romkey/esp32-access-control/hw/reader/0.1.0/esp32-access-control-reader/back.png

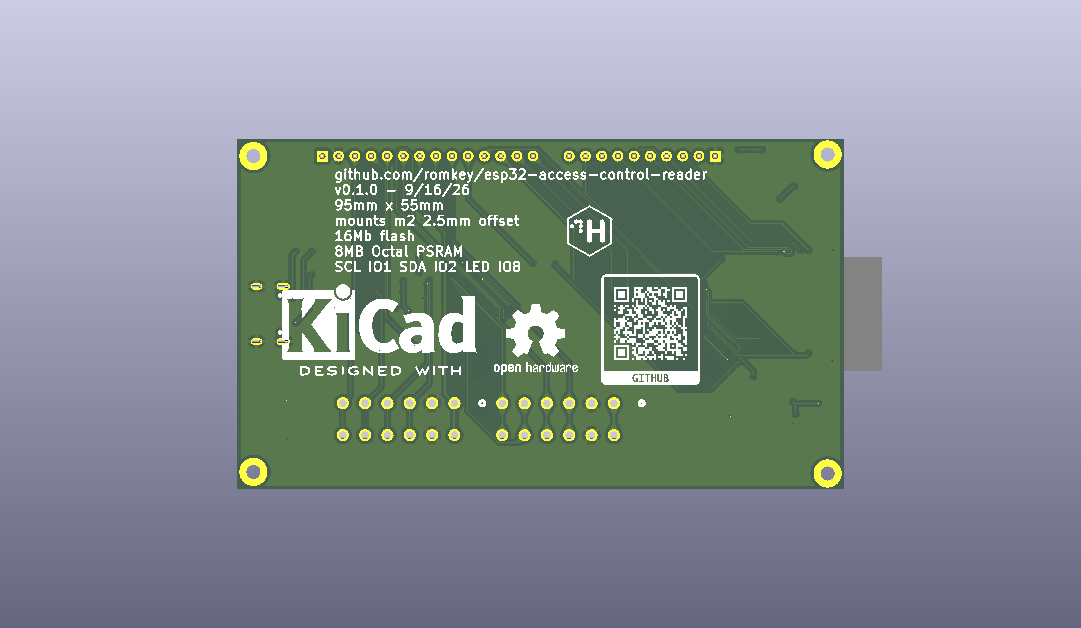
hw/reader/0.1.0/esp32-access-control-reader/back.png
