romkey/esp32-access-control/hw/reader/0.1.0/esp32-access-control-reader/front.png

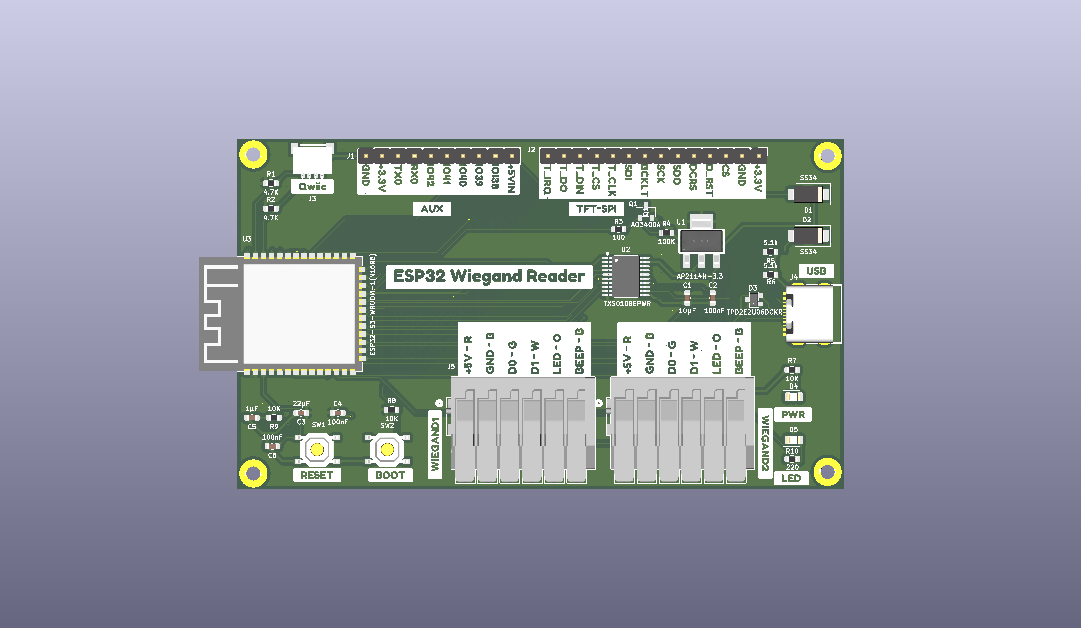
hw/reader/0.1.0/esp32-access-control-reader/front.png
