romkey/esp32-access-control/BOFFF.md

---
bofff_version: 1
board:
  name: ESP32 Access Control Base Board
  version: 0.1.0
  date: '2026-08-30'
  organization: PDX Hackerspace
  license: null
  repository: null
  repository_path: null
  notes:
  - John Romkey
source_files:
  ecad: KiCad
  project: esp32-access-control-reader.kicad_pro
  schematic: esp32-access-control-reader.kicad_sch
  pcb: esp32-access-control-reader.kicad_pcb
  step: null
  dxf: null
  bom: null
form:
  units: mm
  origin: top-left of bounding box, x right, y down
  outline:
    shape: rectangle
    width: 95
    height: 55
  thickness: 1.6
  copper_layers: 2
  max_height_top: null
  max_height_bottom: null
mounting:
  center:
    x: 47.5
    y: 27.5
  center_is: bounding box centre, not the outline centroid
  holes:
  - ref: MNT1
    x: 2.5
    y: 2.5
    offset_x: -45
    offset_y: -25
    diameter: 2.2
  - ref: MNT2
    x: 92.5
    y: 2.75
    offset_x: 45
    offset_y: -24.75
    diameter: 2.2
  - ref: MNT3
    x: 92.5
    y: 52.25
    offset_x: 45
    offset_y: 24.75
    diameter: 2.2
  - ref: MNT4
    x: 2.5
    y: 52.5
    offset_x: -45
    offset_y: 25
    diameter: 2.2
power:
  rails:
  - net: GND
    kind: ground
    connections: 24
  - net: +3V3
    kind: supply
    connections: 12
  - net: +5V
    kind: supply
    connections: 4
  - net: +5V_IN
    kind: supply
    connections: 2
  - net: VBUS
    kind: supply
    connections: 2
  - net: +3.3V
    kind: supply
    connections: 1
  usb:
    present: true
    type: null
    ref: J4
  battery:
    present: false
  input_voltage: null
  current_typical: null
  current_peak: null
connectors:
- ref: J1
  part: Conn_01x10_MountingPin
  footprint: Connector_PinHeader_2.54mm:PinHeader_1x10_P2.54mm_Vertical
  x: 20.13
  y: 2.75
  populated: true
  pins:
  - pad: '1'
    net: GND
  - pad: '2'
    net: /+3.3V
  - pad: '3'
    net: /TX0
  - pad: '4'
    net: /RX0
  - pad: '5'
    net: /IO42
  - pad: '6'
    net: /IO41
  - pad: '7'
    net: /IO40
  - pad: '8'
    net: /IO39
  - pad: '9'
    net: /IO38
  - pad: '10'
    net: /+5V_IN
- ref: J2
  part: '~'
  footprint: Connector_PinHeader_2.54mm:PinHeader_1x14_P2.54mm_Vertical
  x: 81.69
  y: 2.75
  populated: true
  pins:
  - pad: '1'
    net: +3V3
  - pad: '2'
    net: GND
  - pad: '3'
    net: /CS
  - pad: '4'
    net: /DSP_RST
  - pad: '5'
    net: /DCRS
  - pad: '6'
    net: /SDO
  - pad: '7'
    net: /SCK
  - pad: '8'
    net: Net-(J2-LED)
  - pad: '9'
    net: /SDI
  - pad: '10'
    net: /T_CLK
  - pad: '11'
    net: /T_CS
  - pad: '12'
    net: /T_DIN
  - pad: '13'
    net: /T_DO
  - pad: '14'
    net: /T_IRQ
- ref: J3
  part: SM04B-SRSS-TB_(LF)(SN)
  footprint: easyeda2kicad:CONN-SMD_4P-P1.00_SM04B-SRSS-TB-LF-SN
  x: 11.75
  y: 3.5
  populated: true
  pins:
  - pad: '1'
    net: GND
  - pad: '2'
    net: +3V3
  - pad: '3'
    net: /SDA
  - pad: '4'
    net: /SCL
- ref: J4
  part: TYPE-C-31-M-12
  footprint: easyeda2kicad:USB-C-SMD_MC-311D
  x: 89.625
  y: 27.5
  populated: true
  pins:
  - pad: '1'
    net: GND
  - pad: '2'
    net: GND
  - pad: '3'
    net: GND
  - pad: '4'
    net: GND
  - pad: A1-B12
    net: GND
  - pad: A4-B9
    net: VBUS
  - pad: A5
    net: Net-(J4-CC1)
  - pad: A6
    net: /D+
  - pad: A7
    net: /D-
  - pad: B1-A12
    net: GND
  - pad: B4-A9
    net: VBUS
  - pad: B5
    net: Net-(J4-CC2)
  - pad: B6
    net: /D+
  - pad: B7
    net: /D-
- ref: J5
  part: 2601-1106
  footprint: easyeda2kicad:CONN6_2601-1106_WAG
  x: 36
  y: 41.5
  populated: true
  pins:
  - pad: '1'
    net: +5V
  - pad: '2'
    net: +5V
  - pad: '3'
    net: GND
  - pad: '4'
    net: GND
  - pad: '5'
    net: /W1-1
  - pad: '6'
    net: /W1-1
  - pad: '7'
    net: /W1-2
  - pad: '8'
    net: /W1-2
  - pad: '9'
    net: /W1-3
  - pad: '10'
    net: /W1-3
  - pad: '11'
    net: /W1-4
  - pad: '12'
    net: /W1-4
- ref: J6
  part: 2601-1106
  footprint: easyeda2kicad:CONN6_2601-1106_WAG
  x: 61
  y: 41.5
  populated: true
  pins:
  - pad: '1'
    net: +5V
  - pad: '2'
    net: +5V
  - pad: '3'
    net: GND
  - pad: '4'
    net: GND
  - pad: '5'
    net: /W2-1
  - pad: '6'
    net: /W2-1
  - pad: '7'
    net: /W2-2
  - pad: '8'
    net: /W2-2
  - pad: '9'
    net: /W2-3
  - pad: '10'
    net: /W2-3
  - pad: '11'
    net: /W2-4
  - pad: '12'
    net: /W2-4
interfaces:
  i2c:
  - name: primary
    nets:
    - /SCL
    - /SDA
    pullups:
    - ref: R1
      line: SCL
      net: /SCL
      pulls_to: +3V3
      voltage: 3.3
      value: 4.7K
      resistance: 4700
    - ref: R2
      line: SDA
      net: /SDA
      pulls_to: +3V3
      voltage: 3.3
      value: 4.7K
      resistance: 4700
    devices:
    - ref: U3
      part: ESP32-S3-WROOM-1(N16R8)
      address: null
    exposed_on:
    - J3
---

# ESP32 Access Control Base Board — BOFFF

**BOFFF** — a Bill Of Form, Fit and Function. A summary of this
board's physical and electrical facts for anyone designing an
enclosure, a mount, or a mating board.

- **Form** — outline, thickness, layer count.
- **Fit** — mounting holes and connector positions.
- **Function** — power rails and the buses the board exposes.

## Coordinates

Millimetres. The origin is the **top-left corner of the board
outline's bounding box**, with X increasing right and Y increasing
**down**. This is the opposite of the usual mathematical
convention and is the most likely source of a silent error in
anything consuming this file.

Mounting holes additionally carry `offset_x`/`offset_y`, measured
from `mounting.center`, so a symmetric pattern reads as the
matched pair it is. Y still increases **down**, so a hole above
the centre has a negative `offset_y`.

Both anchors are derived from the **bounding box**, so both are
well defined for any outline — but on a board that is not a
rectangle, neither need be a point on the board. The top-left of
a round board's bounding box sits in free space, and the centre
of an irregular one is the box's centre, not the outline's
centroid. Check `form.outline.shape` before measuring to either.

## Generated, not authored

Everything above was extracted from the KiCad files listed under
`source_files`. Regenerate it rather than editing it by hand:

```bash
kilint bofff . > BOFFF.md
```

For exact geometry — curves, slots, internal cutouts, component
heights — use the STEP/DXF exports rather than this summary. A
bounding box is not an outline.

## Complete by hand

These are not recorded in the KiCad files and are emitted as
`null`. They need a human:

- `form.max_height_top` — tallest component above the board; from the 3D models, not the PCB
- `form.max_height_bottom` — tallest component below the board; same
- `power.input_voltage` — the operating range; the netlist does not say
- `power.current_typical` — a measurement
- `power.current_peak` — a measurement
- `source_files.step` — path to the 3D export, once you make one
- `source_files.dxf` — path to the 2D outline export, once you make one
- `source_files.bom` — path to the exported BOM
- `board.repository_path` — the project is not inside a git repository
- `board.license` — no license found in the title block or silkscreen
