romkey/esp32-access-control/hw/reader/0.1.0/esp32-access-control-reader/esp32-access-control-reader.pdf

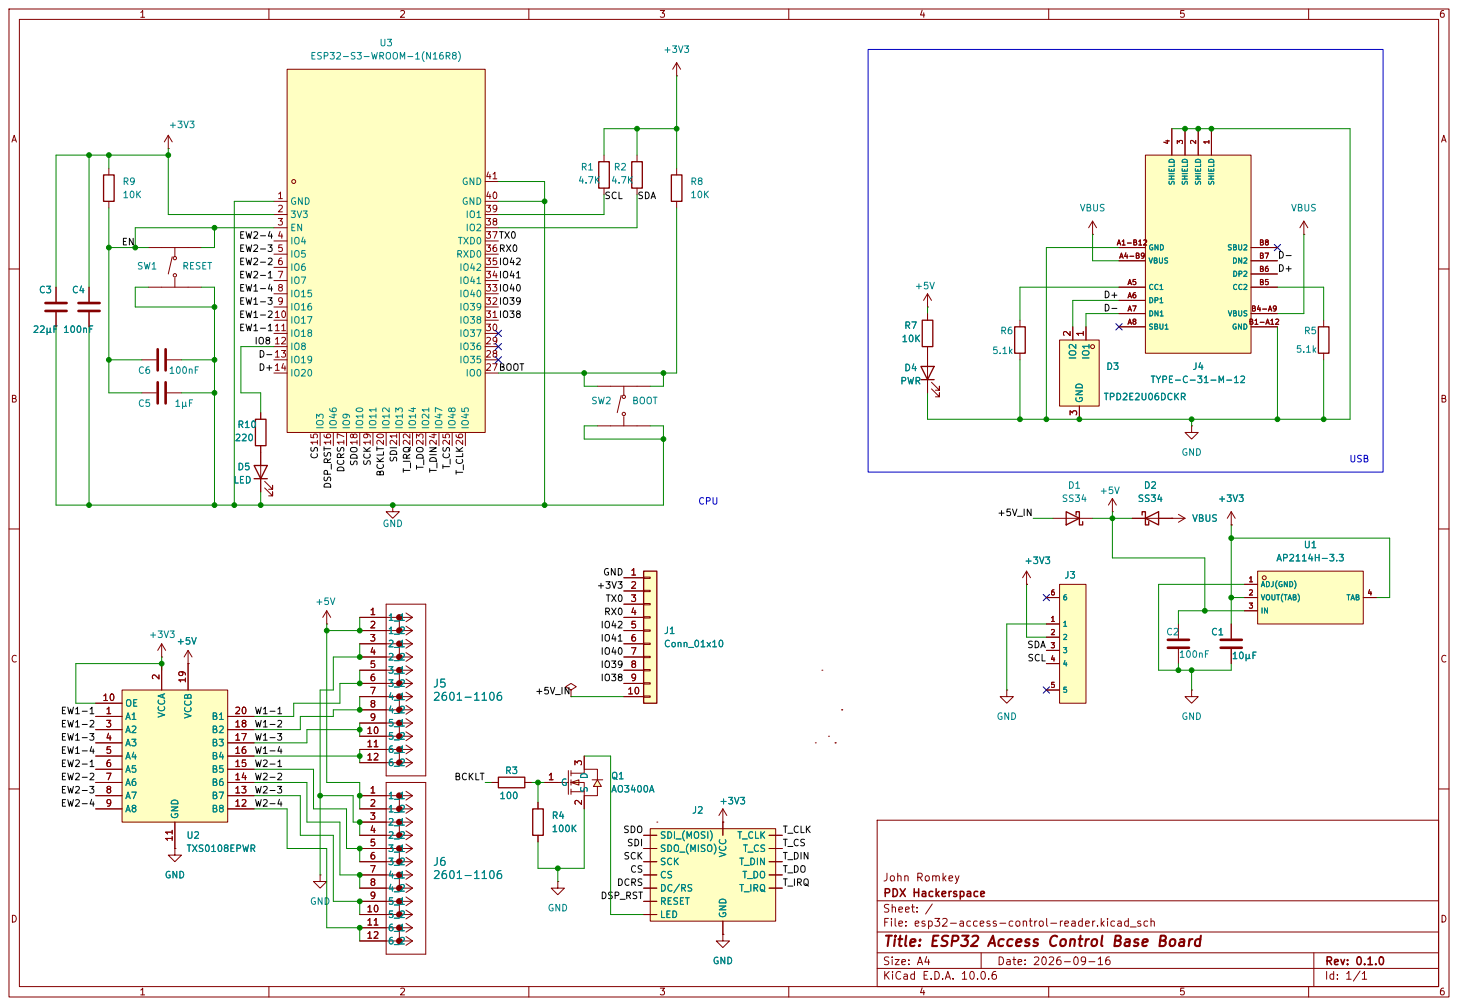
[picture p4: page 1]

3_2 6
4_1 7
4_2 8
5_1 9

PDX Hackerspace
Sheet: /
File: esp32-access-control-reader.kicad_sch
Title: ESP32 Access Control Base Board

Size: A4 | Rev: 0.1.0
KiCad E.D.A. 10.0.6 | Id: 1/1
