romkey/esp32-access-control/hw/reader/0.1.0/esp32-access-control-reader/esp32-access-control-reader.kicad_pcb

## KiCad design hw/reader/0.1.0/esp32-access-control-reader/esp32-access-control-reader.kicad_pcb (2026-09-30)

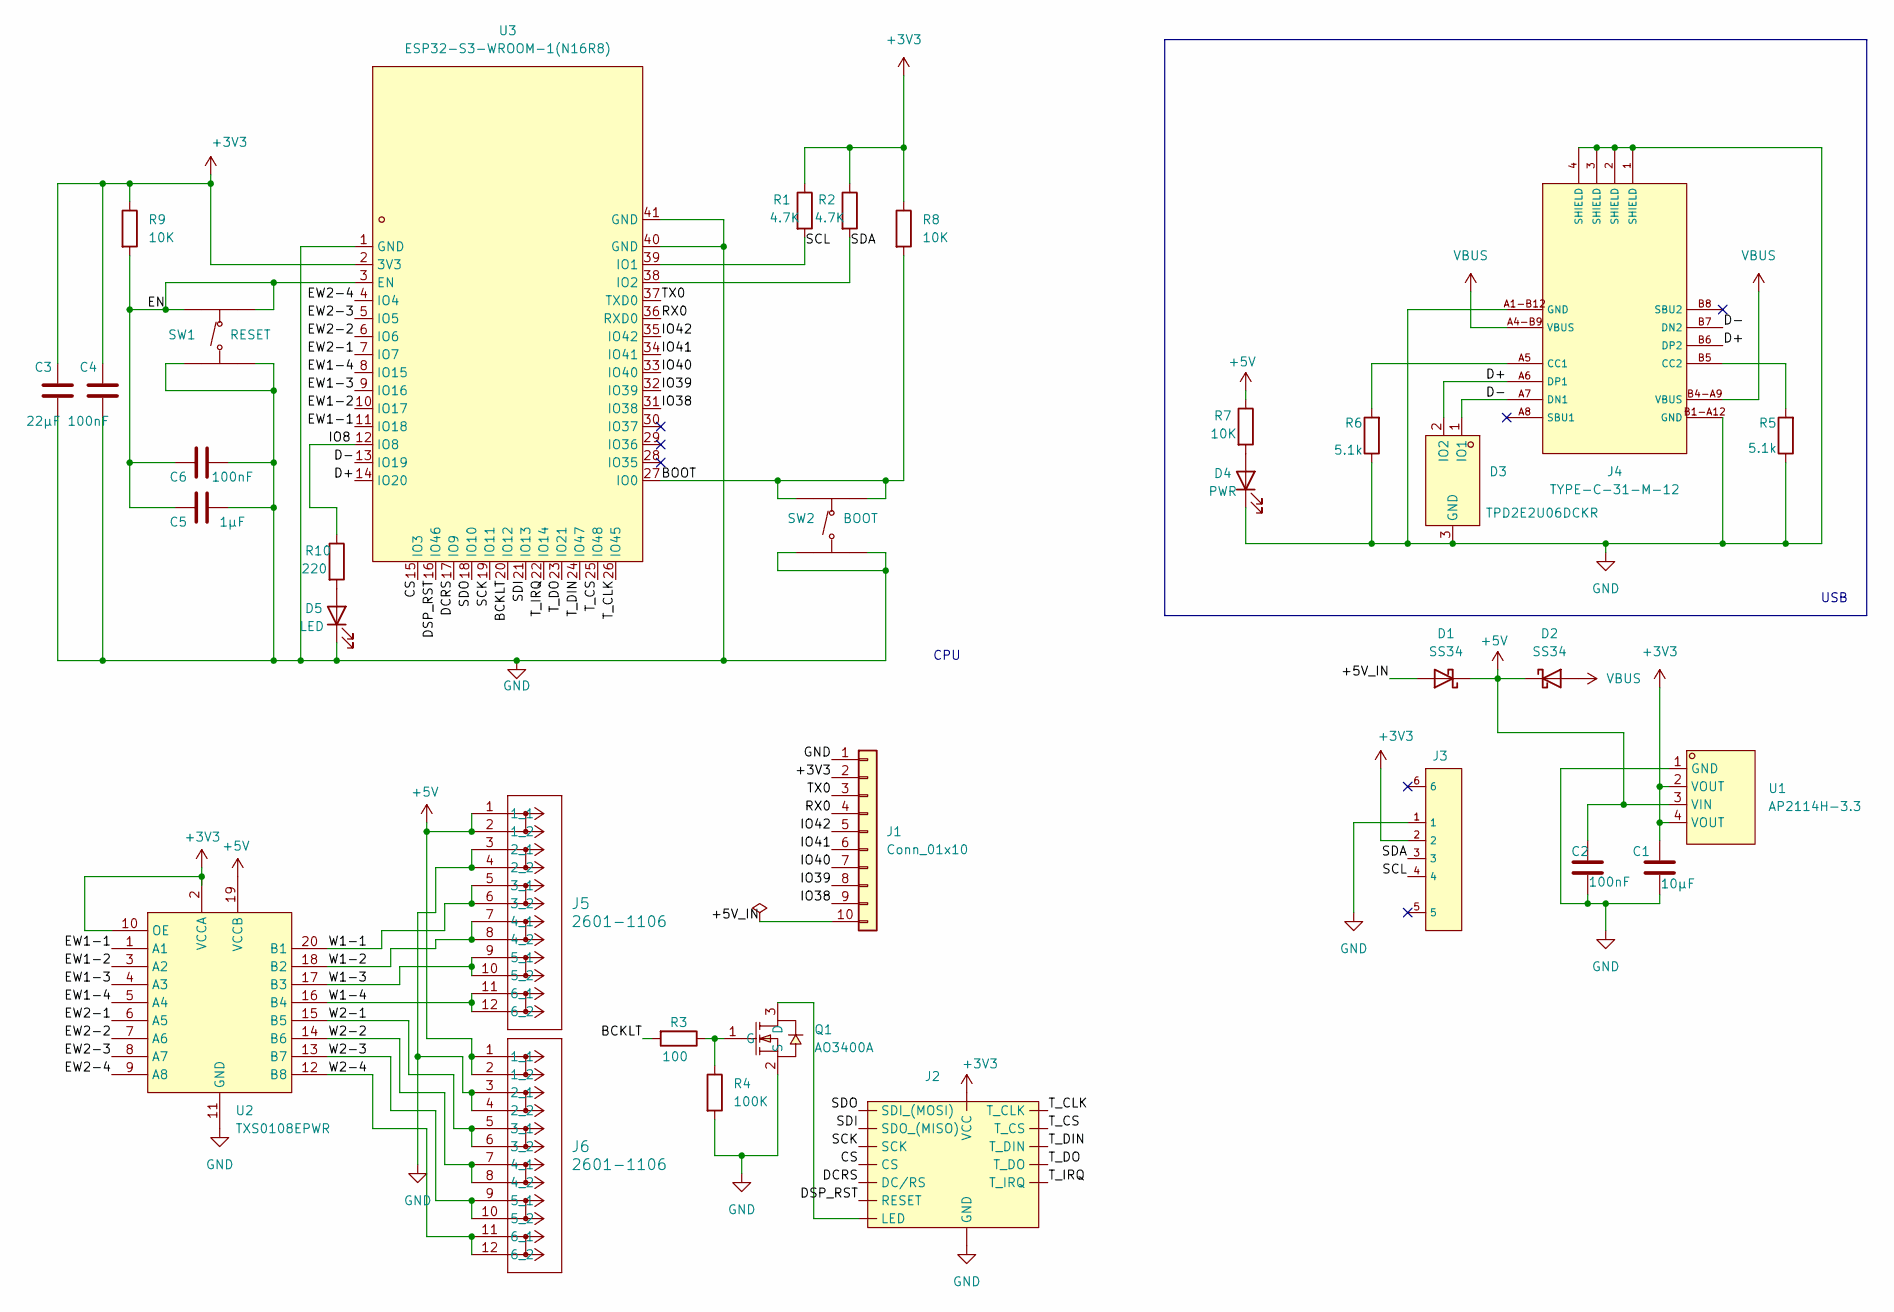
[picture p5: schematic esp32-access-control-reader.kicad_sch, ESP32 Access Control Base Board]

Parts:
C1: 10µF; C_0603_1608Metric; LCSC C19702
C2, C4, C6: 100nF; C_0603_1608Metric; LCSC C14663
C3: 22µF; C_0603_1608Metric; LCSC C59461
C5: 1µF; C_0603_1608Metric; LCSC C15849
D1, D2: SS34; D_SMA; LCSC Part C8678
D3: TPD2E2U06DCKR; SC-70-3_L2.0-W1.3-P0.65-LS2.1-BL; LCSC Part C1855726
D4: PWR; LED_0805_2012Metric; LCSC C84256
D5: LED; LED_0805_2012Metric; LCSC C2297
J1: Conn_01x10; PinHeader_1x10_P2.54mm_Vertical
J2: PinHeader_1x14_P2.54mm_Vertical
J3: SM04B-SRSS-TB_(LF)(SN); CONN-SMD_4P-P1.00_SM04B-SRSS-TB-LF-SN; LCSC C160404
J4: TYPE-C-31-M-12; USB-C-SMD_MC-311D; LCSC C136423
J5, J6: 2601-1106; CONN6_2601-1106_WAG
Q1: AO3400A; SOT-23-3_L2.9-W1.3-P1.90-LS2.4-BR; LCSC Part C20917
R1, R2: 4.7K; R_0603_1608Metric; LCSC C23162
R3: 100; R_0603_1608Metric; LCSC Part C22775
R4: 100K; R_0603_1608Metric; LCSC Part C25803
R5, R6: 5.1k; R_0603_1608Metric; LCSC C23186
R7, R8, R9: 10K; R_0603_1608Metric; LCSC C25804
R10: 220; R_0603_1608Metric; LCSC C22962
SW1: RESET; SW-SMD_4P-L5.1-W5.1-P3.70-LS6.5-TL_H1.5; LCSC C318884
SW2: BOOT; SW-SMD_4P-L5.1-W5.1-P3.70-LS6.5-TL_H1.5; LCSC C318884
U1: AP2114H-3.3; SOT-223_L6.7-W3.5-P2.30-BR; LCSC C150716
U2: TXS0108EPWR; TSSOP-20_L6.5-W4.4-P0.65-LS6.4-BL; LCSC Part C17206
U3: ESP32-S3-WROOM-1(N16R8); WIRELM-SMD_ESP32-S3-WROOM-1; LCSC Part C2913202

Connections:
+3V3: C1.1, C3.1, C4.1, J1.2, J2.1 (VCC), J3.2, R1.1, R2.1, R8.1, R9.1, U1.2 (VOUT), U1.4 (VOUT), U2.2 (VCCA), U2.10 (OE), U3.2 (3V3)
+5V: C2.1, D1.1 (K), D2.1 (K), J5.1 (1_1), J5.2 (1_2), J6.1 (1_1), J6.2 (1_2), R7.1, U1.3 (VIN), U2.19 (VCCB)
/+5V_IN: D1.2 (A), J1.10
/BCKLT: R3.2, U3.20 (IO12)
/BOOT: R8.2, SW2.1 (A), SW2.2 (B), U3.27 (IO0)
/CS: J2.3 (CS), U3.15 (IO3)
/D+: D3.2 (IO2), J4.A6 (DP1), J4.B6 (DP2), U3.14 (IO20)
/D-: D3.1 (IO1), J4.A7 (DN1), J4.B7 (DN2), U3.13 (IO19)
/DCRS: J2.5 (DC/RS), U3.17 (IO9)
/DSP_RST: J2.4 (RESET), U3.16 (IO46)
/EN: C5.1, C6.1, R9.2, SW1.1 (A), SW1.2 (B), U3.3 (EN)
/EW1-1: U2.1 (A1), U3.11 (IO18)
/EW1-2: U2.3 (A2), U3.10 (IO17)
/EW1-3: U2.4 (A3), U3.9 (IO16)
/EW1-4: U2.5 (A4), U3.8 (IO15)
/EW2-1: U2.6 (A5), U3.7 (IO7)
/EW2-2: U2.7 (A6), U3.6 (IO6)
/EW2-3: U2.8 (A7), U3.5 (IO5)
/EW2-4: U2.9 (A8), U3.4 (IO4)
/IO8: R10.1, U3.12 (IO8)
/IO38: J1.9, U3.31 (IO38)
/IO39: J1.8, U3.32 (IO39)
/IO40: J1.7, U3.33 (IO40)
/IO41: J1.6, U3.34 (IO41)
/IO42: J1.5, U3.35 (IO42)
/RX0: J1.4, U3.36 (RXD0)
/SCK: J2.7 (SCK), U3.19 (IO11)
/SCL: J3.4, R1.2, U3.39 (IO1)
/SDA: J3.3, R2.2, U3.38 (IO2)
/SDI: J2.9 (SDO_(MISO)), U3.21 (IO13)
/SDO: J2.6 (SDI_(MOSI)), U3.18 (IO10)
/TX0: J1.3, U3.37 (TXD0)
/T_CLK: J2.10 (T_CLK), U3.26 (IO45)
/T_CS: J2.11 (T_CS), U3.25 (IO48)
/T_DIN: J2.12 (T_DIN), U3.24 (IO47)
/T_DO: J2.13 (T_DO), U3.23 (IO21)
/T_IRQ: J2.14 (T_IRQ), U3.22 (IO14)
/W1-1: J5.5 (3_1), J5.6 (3_2), U2.20 (B1)
/W1-2: J5.7 (4_1), J5.8 (4_2), U2.18 (B2)
/W1-3: J5.9 (5_1), J5.10 (5_2), U2.17 (B3)
/W1-4: J5.11 (6_1), J5.12 (6_2), U2.16 (B4)
/W2-1: J6.5 (3_1), J6.6 (3_2), U2.15 (B5)
/W2-2: J6.7 (4_1), J6.8 (4_2), U2.14 (B6)
/W2-3: J6.9 (5_1), J6.10 (5_2), U2.13 (B7)
/W2-4: J6.11 (6_1), J6.12 (6_2), U2.12 (B8)
GND: C1.2, C2.2, C3.2, C4.2, C5.2, C6.2, D3.3 (GND), D4.1 (K), D5.1 (K), J1.1, J2.2 (GND), J3.1, J4.1 (SHIELD), J4.2 (SHIELD), J4.3 (SHIELD), J4.4 (SHIELD), J4.A1-B12 (GND), J4.B1-A12 (GND), J5.3 (2_1), J5.4 (2_2), J6.3 (2_1), J6.4 (2_2), Q1.2 (S), R4.2, R5.1, R6.1, SW1.3 (C), SW1.4 (D), SW2.3 (C), SW2.4 (D), U1.1 (GND), U2.11 (GND), U3.1 (GND), U3.40 (GND), U3.41 (GND)
unnamed: D4.2 (A), R7.2
unnamed: D5.2 (A), R10.2
unnamed: J2.8 (LED), Q1.3 (D)
unnamed: J4.A5 (CC1), R6.2
unnamed: J4.B5 (CC2), R5.2
unnamed: Q1.1 (G), R3.1, R4.1
VBUS: D2.2 (A), J4.A4-B9 (VBUS), J4.B4-A9 (VBUS)

Notes on the sheet:
CPU
USB

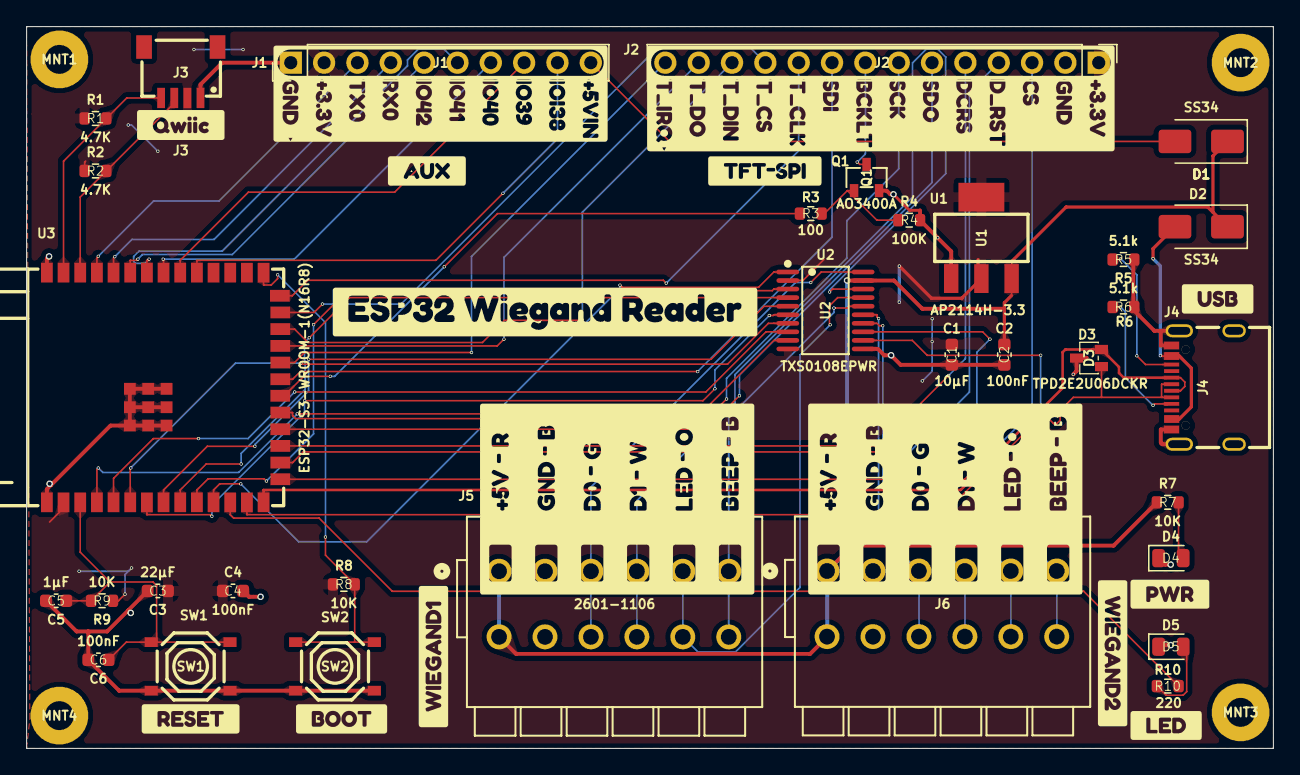
[picture p6: board esp32-access-control-reader.kicad_pcb from above]

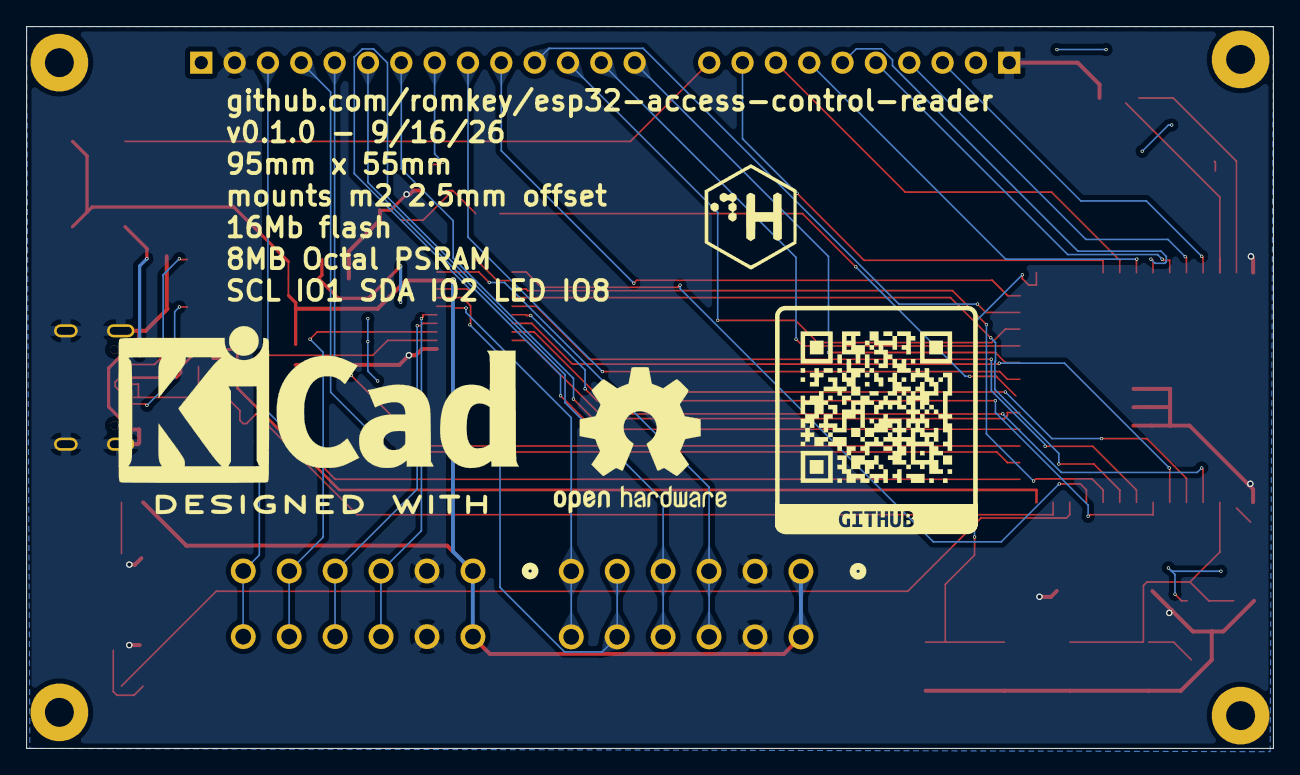
[picture p7: board esp32-access-control-reader.kicad_pcb from below]

Board: 2 copper layers, 95.0 x 55.0 mm, 54 parts (2 on the bottom side), 53 nets.

Other parts of the board:
MNT1, MNT2, MNT3, MNT4: MountingHole_2.2mm_M2_Pad
NOT2: CTRLH Logo
kobee-studio-1: G***; kobee-studio-6AA82569
kobee-studio-2: G***; kobee-studio-6AA4CD99
kobee-studio-3: G***; kobee-studio-6A958584
kobee-studio-4: G***; kobee-studio-6AA4CF77
kobee-studio-5: G***; kobee-studio-6AA4CF94
kobee-studio-6: G***; kobee-studio-6A95859C
kobee-studio-6AAB212F: G***; kobee-studio-6AAB212F
kobee-studio-7: G***; kobee-studio-6AA480A6
kobee-studio-8, kobee-studio-9: Kobee Studio; kobee-studio-6AA40528
kobee-studio-10: G***; kobee-studio-6AA432D5
kobee-studio-11: G***; kobee-studio-6AA2D906
kobee-studio-12: G***; kobee-studio-6AA2D8EB
kobee-studio-13: G***; kobee-studio-6A950CF3
kobee-studio-14: G***; kobee-studio-6A950CDA
kobee-studio-15: G***; kobee-studio-6AA432BC
