romkey/esp32-access-control/(commit log)

2026-10-19 Add OpenSCAD kiosk case with CI and README badge
    Parametric case for the access control board with a 3.5in or 4.0in SPI
    TFT and an HID ProxPoint Plus reader on the front. Includes an optional
    desk stand and a workflow that renders the STLs.
2026-10-19 Add landscape layout for the case
    Display above reader with both turned sideways, for 3.5in and 4.0in
    displays. Output files are now named <part>-<orientation>-<display>.
2026-10-19 Move the bring-up config to examples/
    CI builds device configs from examples/ with the dummy secrets, and the
    secrets hook rejects !secret under firmware/. The LAN address is marked
    not-a-secret; it was already in the first commit.
2026-10-20 Bring the door-controller firmware to the rules' layout
    Move the C++ components to components/, split the board-agnostic logic into
    packages/ (pins are substitutions), and add examples/access-control.yaml and
    examples/common/base.yaml with encrypted api/ota, recovery buttons and an
    authenticated web server. simple.yaml now uses the shared base. The API key,
    OTA password and fallback hotspot password that were hard-coded in the local
    firmware config are !secret. Door relay pins are placeholders.
2026-10-20 Teach actionlint the ubuntu-26.04 runner label
    Renovate moved the Case workflow to ubuntu-26.04 and its runs succeed,
    but the pinned actionlint release doesn't list the label, so Lint failed.
2026-10-20 Switch the reader LED and beeper off after a grant; say the unlock endpoint only logs
    The grant path turned the reader LED and beeper on and never off. A
    wiegand_acknowledge script now pulses them (150 ms beep, 500 ms LED, like
    simple.yaml).
    The unlock endpoint records 'unlocked by <person>' in syslog and has never
    operated the relay; the package comments and docs called it remote unlock.
    They now say what it does.
2026-10-20 Accept a hostname as the syslog server
    send_message passed the server only to inet_pton(AF_INET), so a hostname
    failed on every event and nothing was ever logged. The server may now be an
    IPv4 literal (fast path) or a hostname, resolved with getaddrinfo(AF_INET)
    once and cached; after a failed lookup it retries at most every 30 seconds
    so a dead resolver can't stall the loop. IPv6 would need an AF_INET6 socket
    and lwIP IPv6, which this firmware doesn't enable, so config validation now
    rejects IPv6 literals, ports and URLs with a clear message.
2026-10-20 Resolve the syslog hostname in a background task
    getaddrinfo() blocks for the resolver timeout, and send_message runs on the
    main loop right after a granted tag unlocks the door, so an unresolved
    hostname could freeze the loop with the strike energised. A short-lived
    FreeRTOS task now does the lookup (getaddrinfo is the call ESP-IDF supports
    from any task; lwIP's dns_gethostbyname needs the tcpip core lock and a
    callback on the tcpip thread). send_message only reads the cached address,
    and holds the latest 8 messages until it is known. The address is looked up
    again after a Wi-Fi reconnect or a failed send. IPv4 literals, the 30 s retry
    spacing and the IPv6 rejection are unchanged.
    Co-Autho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
2026-10-20 Make the shared state in access_syslog and access_db thread-safe
    The main loop, the HTTP server task and the DNS task all touched the syslog
    queue, resolved address and resolve flags without a common lock, so two DNS
    tasks could start and the queue could be read while it was modified. Now
    send_message() only queues under one mutex, only the main loop uses the
    socket and starts the (single) DNS task, and the task publishes its result
    under the same mutex. No lock is held across getaddrinfo, sendto or logging.
    access_db had the same problem: lookups on the main loop read the header,
    last match and database file while an upload on the HTTP task replaced them.
    One mutex now guards those and the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
2026-10-20 Retry upload receive timeouts and clean up every failed upload
    httpd_req_recv returns HTTPD_SOCK_ERR_TIMEOUT for a stalled but live
    connection, but the PUT upload treated it like a closed socket: it returned
    with no reply, leaving busy_ set and the status stuck on 'receiving'.
    Timeouts are now retried for up to 30 s, then the upload is aborted with a
    408; a closed or failed socket discards the temp files, resets busy_ and the
    status and returns ESP_FAIL so httpd closes the socket (as the IDF requires
    after a recv error). A rejected upload is answered at once and the socket
    closed rather than leaving an unread body on a kept-alive connection.
    A watchdog in loop() clears a busy flag stuck by a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
2026-10-20 Describe door-relays as an example package, not an open decision
    The board has no relay output, so nothing is waiting on a wiring decision.
    The docs and comments now say door-relays is an example for a relay or
    strike on the J1 aux header or a satellite board, that its pins are a
    required substitution users set for their own hardware, and that GPIO38/39
    are example values. No behaviour change.
